aggrc/Dechorionation-Cell-Dissociation-DCD-Microfluidic-Device/Dechorionation–Cell Dissociation (DCD) Microfluidic Device.JPG

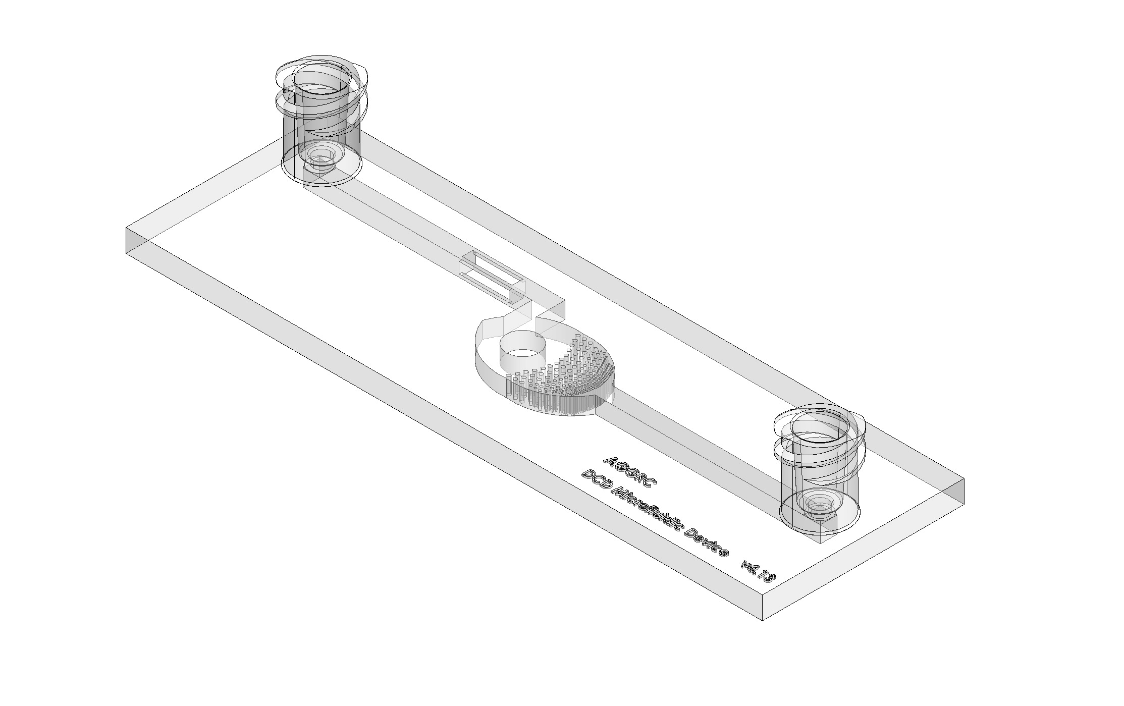
Dechorionation–Cell Dissociation (DCD) Microfluidic Device.JPG
