aggrc/Dechorionation-Cell-Dissociation-DCD-Microfluidic-Device/Dechorionation–Cell Dissociation (DCD) Microfluidic Device-v4-13.3MF

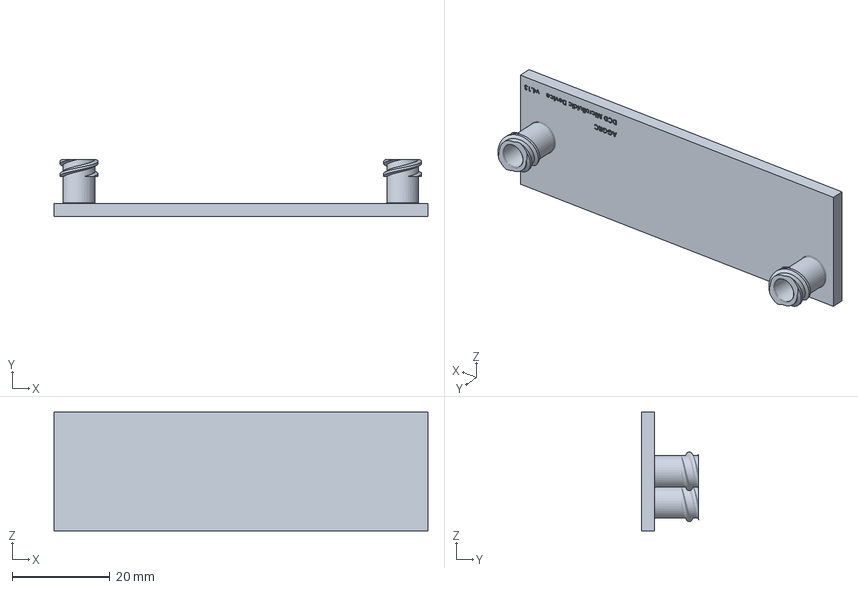
[picture p2: CAD file, 2026-05-25]
Dechorionation–Cell Dissociation (DCD) Microfluidic Device-v4-13.3MF
76.4 x 11.7 x 24.2 mm
