aggrc/Dechorionation-Cell-Dissociation-DCD-Microfluidic-Device/(list of files, cad)

Other CAD files:
Dechorionation–Cell Dissociation (DCD) Microfluidic Device-v4-13.STL
